ansh-bhura/smart-slot/figures/fig1_delta_by_prop.png

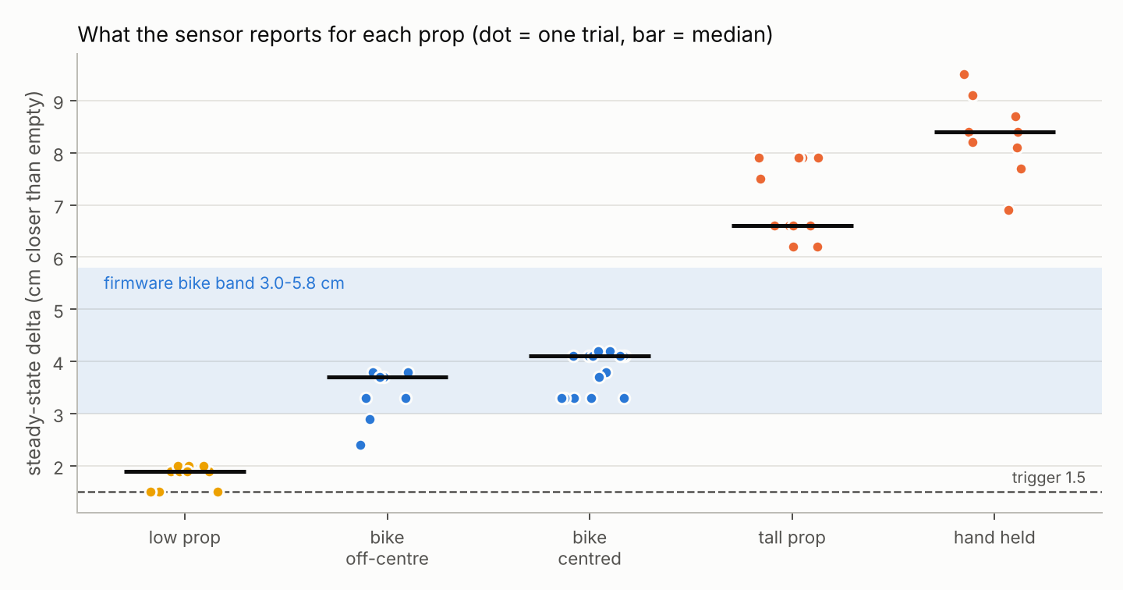
figures/fig1_delta_by_prop.png
