ansh-bhura/smart-slot/figures/fig2_headline.png

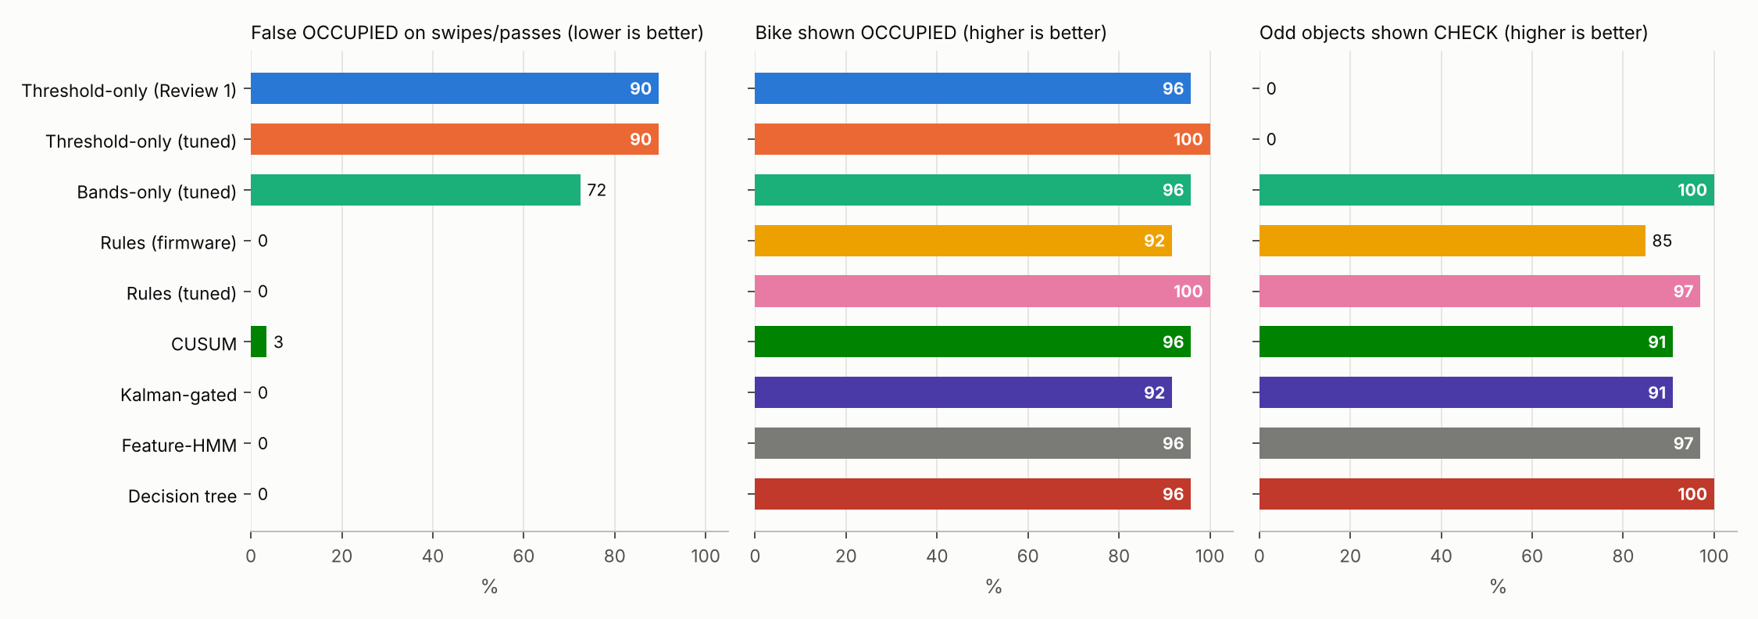
figures/fig2_headline.png
