ansh-bhura/smart-slot/figures/fig3_example_traces.png

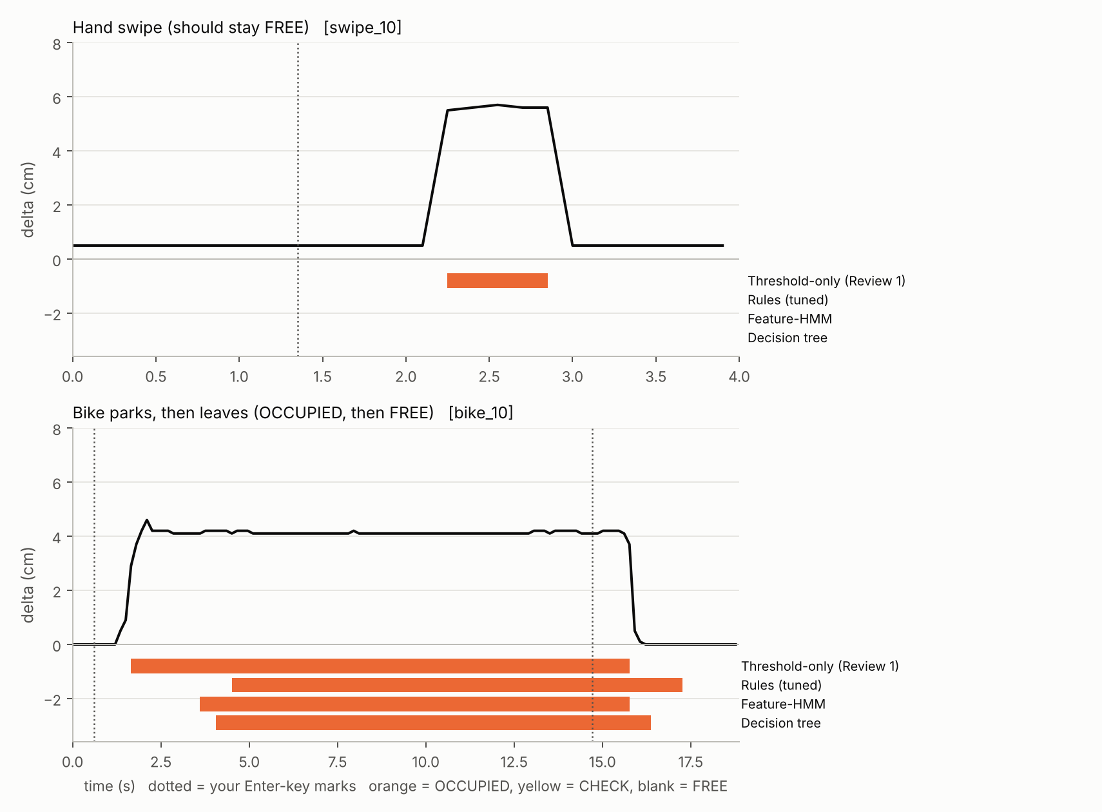
figures/fig3_example_traces.png
