ansh-bhura/smart-slot/figures/fig4_baseline_sensitivity.png

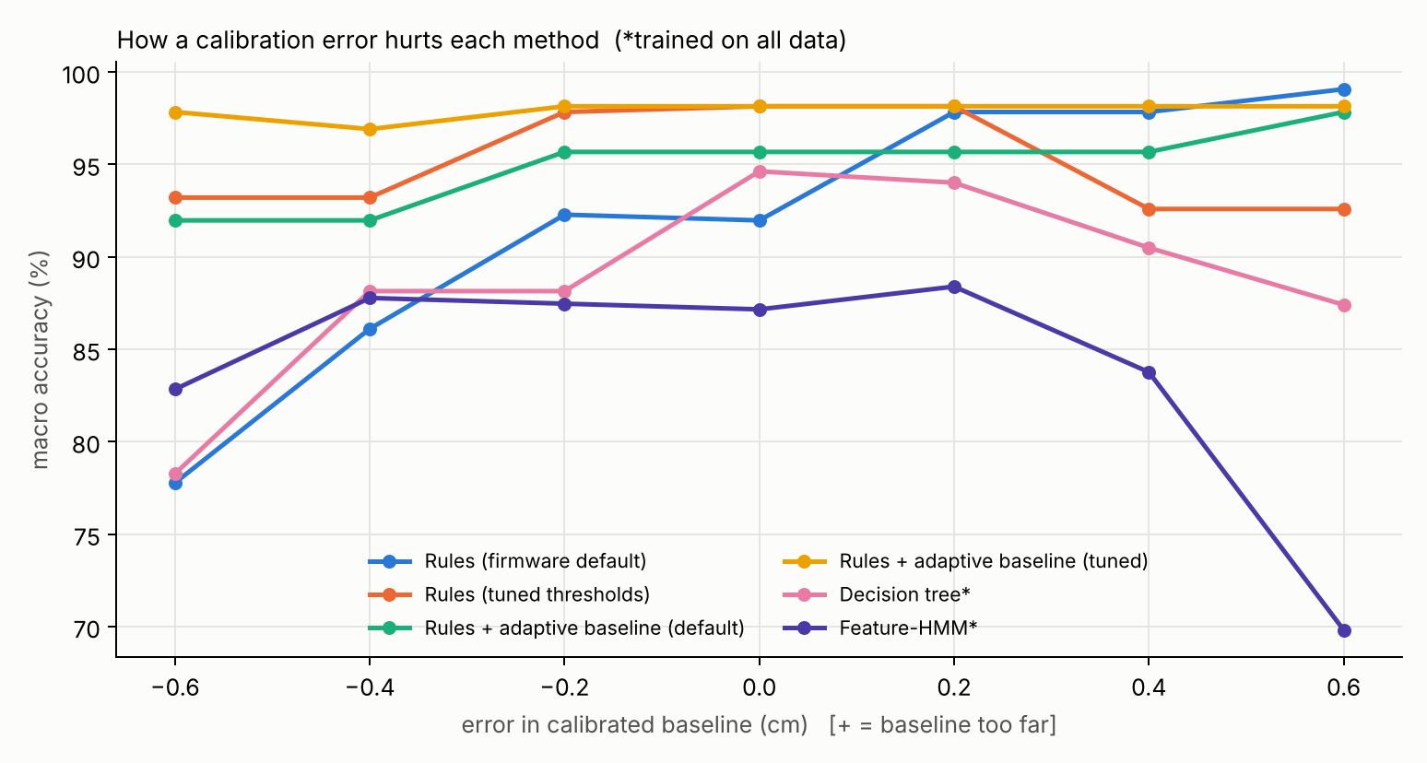
figures/fig4_baseline_sensitivity.png
